ClearMemory041063/DigitalReadout/Pictures/DrillingPatternofHoles.png

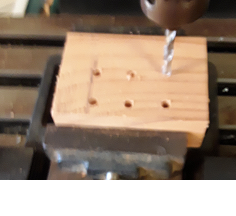
Pictures/DrillingPatternofHoles.png
