ClearMemory041063/DigitalReadout/Software/SDRO1H_03.pdf

SDRO1H_03 Adding a File Picker Joe McCarty
Introduction
The previous versions of SDRO1 used file path and filename editor boxes to read a commas separated pattern file. The SDRO1H_03 changes this to provide an implicitly activated file picking application. The application used is AndExplorer by Lyseoft. https://play.google.com/store/apps/details?id=lysesoft.andexplorer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

Operation:

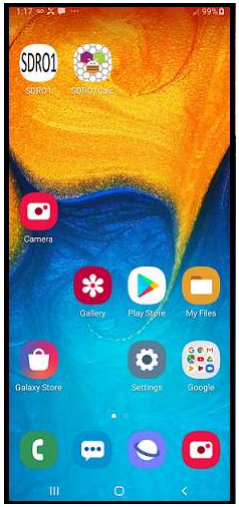
[picture p10: figure]

Start the SDRO1 Application

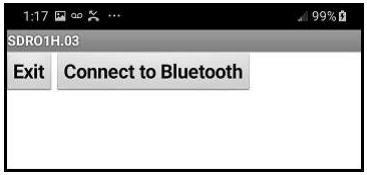
[picture p11: figure]

SDRO1 opens, press the Connect to Bluetooth button

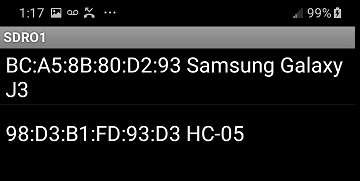
[picture p12: figure]

Select the Arduino circuit device from the list of paired Bluetooth devices.

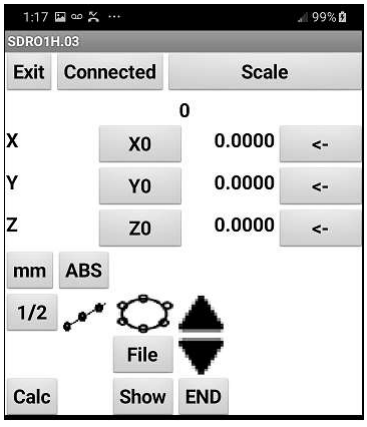
[picture p13: figure]

The Main SDRO1 screen appears. Press the file button.

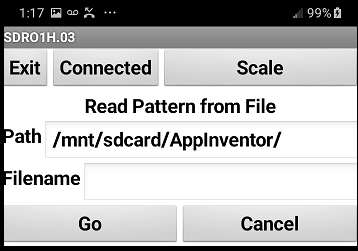
[picture p14: figure]

The Read Pattern from File screen appears. Edit the starting search path if needed. Press GO

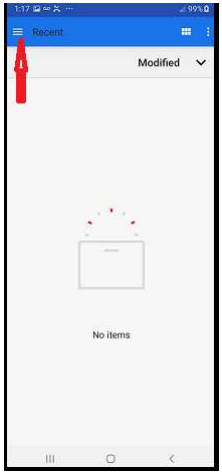
[picture p15: figure]

The content of this screen will depend on your Android device and the loaded Apps. Press the 3 bar button at the upper left marked in this screenshot by the red arrow.

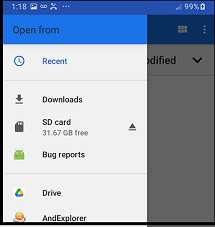
[picture p16: figure]

Again the screen content will vary. Select the AndExplorer

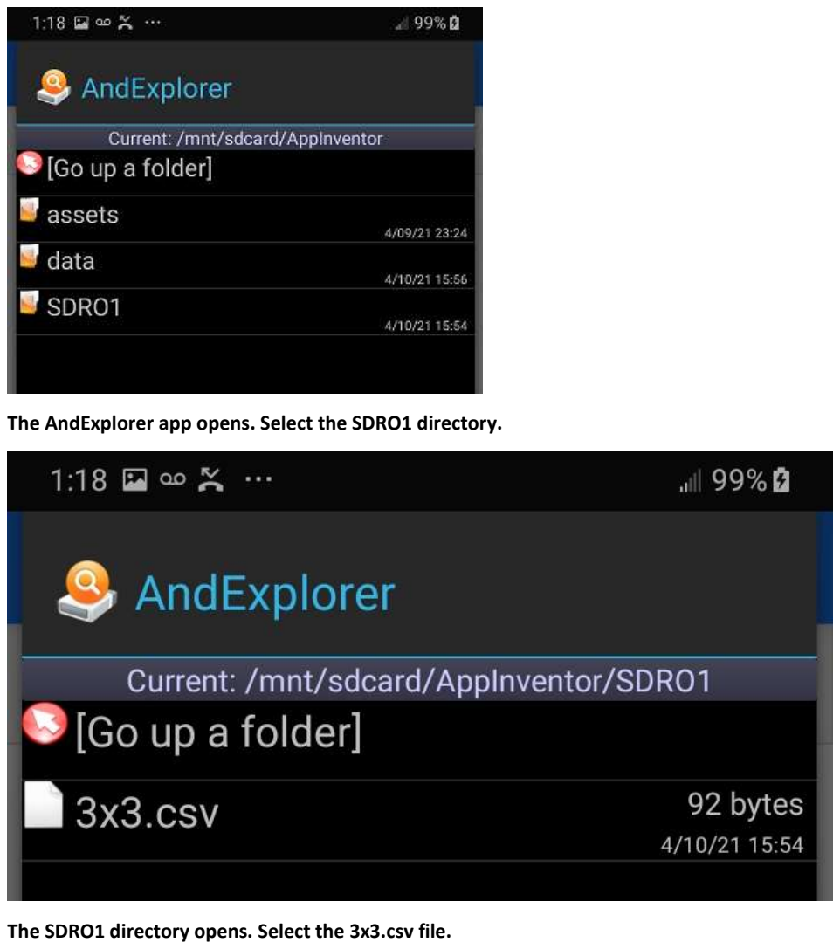
[picture p17: page 5]

The AndExplorer app opens. Select the SDRO1 directory.

The SDRO1 directory opens. Select the 3x3.csv file.

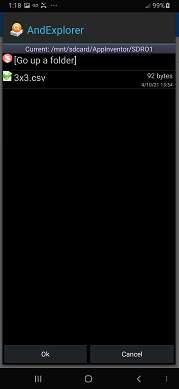
[picture p18: figure]

The 3x3.csv file is selected. Press the OK button near the bottom left.

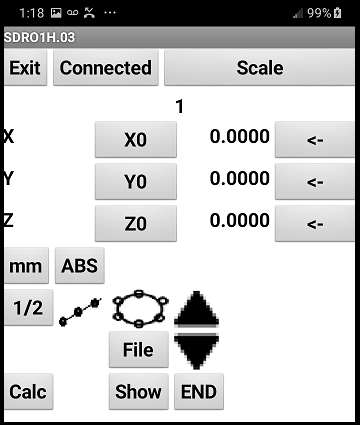
[picture p19: figure]

The file has been read. Press Show to see the results.

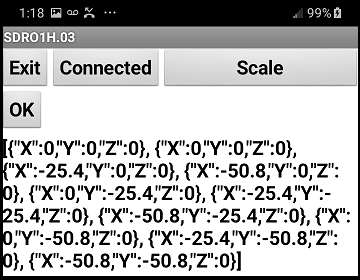
[picture p20: figure]

The data pattern imported from the 3x3.cav file.
