ClearMemory041063/DigitalReadout/AppInventorAIAfiles/Compilation Notes When Using Activity Starter to Launch an App from an App.pdf

Compilation Notes When Using Activity Starter to Launch an App from an App Joe McCarty

In this case SDRO1H_02 uses the App Inventor Activity Starter component to start SDRO1calc_B application. If you decide to recompile the calculator application a variable in the SDRO1H application will need to be changed as well.
The Block in SDRO1H

Wil need to change.

### 1. Once the calculator application is ready

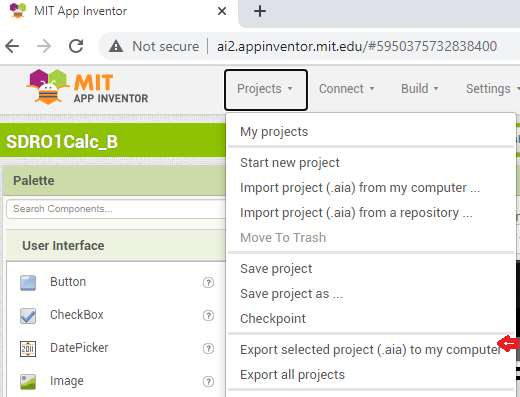
[picture p28: figure]

Export it as an aia file.

### 2. Copy the aia file to a suitable location and change the aia extension to zip

### 3. Unzip the file

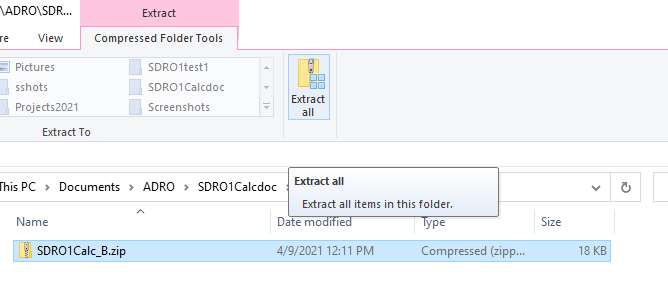
[picture p29: figure]
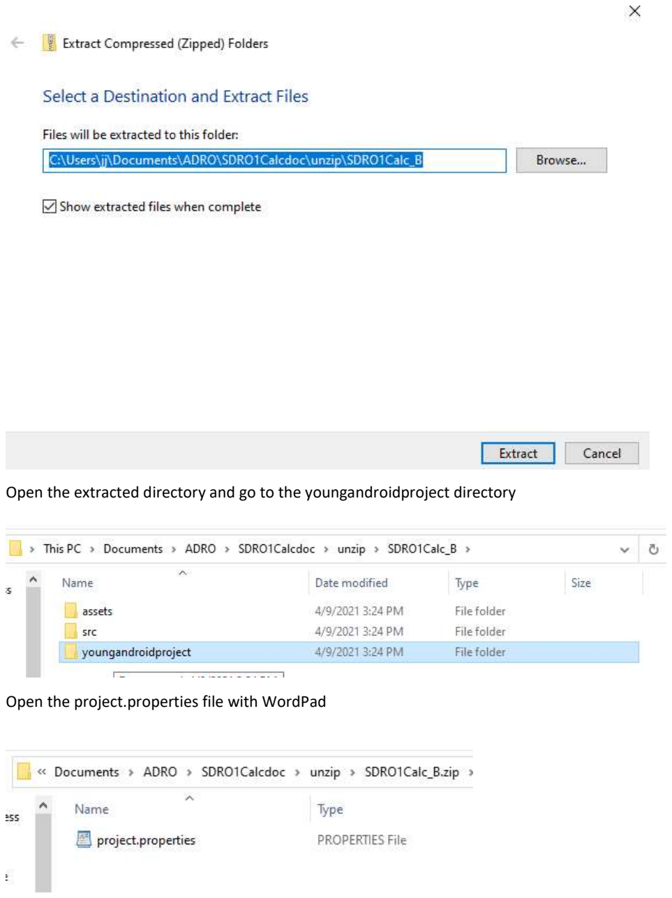
[picture p30: page 3]

Open the extracted directory and go to the youngandroidproject directory

Open the project.properties file with WordPad

The first line starting with main supplies the needed information.

main=appinventor.ai_joemac5774.SDRO1Calc_B.Screen1
