ClearMemory041063/DigitalReadout/TestRun/SDRO1 Drilling a Pattern of Holes Test.pdf

SDRO1 Drilling a Pattern of Holes Test Joe McCarty

Setup

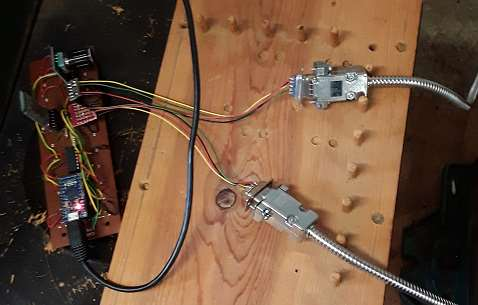
[picture p42: figure]

The rotary encoders for the X and Y axis were unplugged and DB9 connectors were installed and connected to the X and Y axis linear sensors on the milling machine.

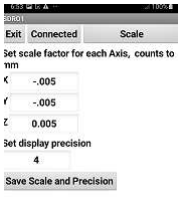
[picture p43: figure]

The SDRO1 application was started and the Scale option was used to set -0.005 into the X and Y axis so that readings from the sensors conform to the milling machine. The first bug was discovered here. The inch/mm is not being read correctly from the Android tinyDB. Pressing the inch/mm button a couple of times resolves the issue for now. I’ve made a note to fix this.

Centering

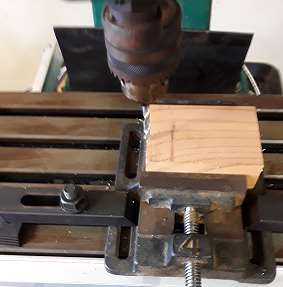
[picture p44: figure]

A section of 2x4 lumber was clamped into the vise and the X-axis moved to the left edge of the workpiece. The X-axis was zeroed in Incremental mode.

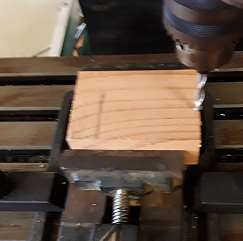
[picture p45: figure]

The X-axis was then moved to the right edge of the workpiece.

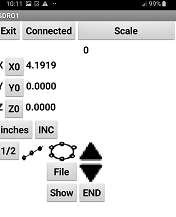
[picture p46: figure]

The X-axis shows the position of the drill bit over the right edge of the work piece.

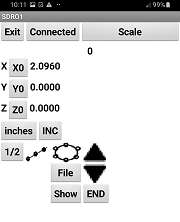
[picture p47: figure]

Pressing the ½ button changes the X-axis display to one half of its previous value.

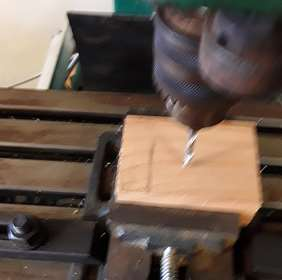
[picture p48: figure]

The handle of the X-axis is turned to bring the X-Axis display to zero. This centers the drill bit on the X-axis of the workpiece.

The process is repeated to center the Y-Axis.

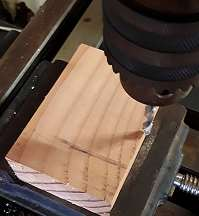
[picture p49: figure]
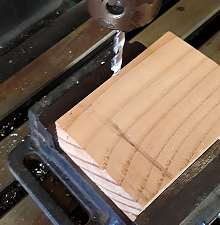
[picture p50: figure]
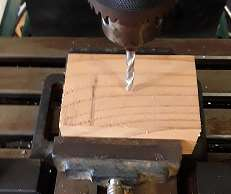
[picture p51: figure]

Drill bit centered over the workpiece

Move to Starting point X=-1, Y=-1

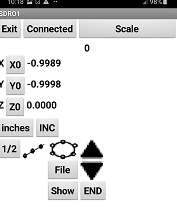
[picture p52: figure]
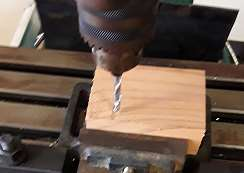
[picture p53: figure]

Zero the X and Y axis on the Android display
Drilling the 3x3 Hole Pattern from a CSV File
Pressing the File button on the App brings up this screen.

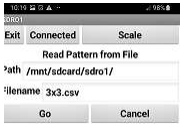
[picture p54: figure]

Press Go to load the file.

Press Show to display the JSON pattern in mm

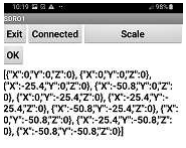
[picture p55: figure]

Press OK
Drill the first hole

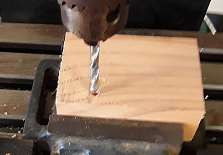
[picture p56: figure]

To go to the next hole press the | key. To go to the previous hole press the | key.
The End button will end the pattern and clear it from the App.

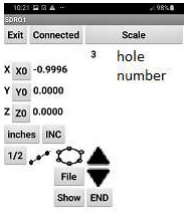
[picture p57: figure]

At hole number 2 position the up arrow was pressed for hole 3. The machine’s X-Axis handle is then turned to zero the X-Axis.

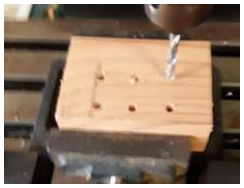
[picture p58: figure]

Drilling the 6th hole

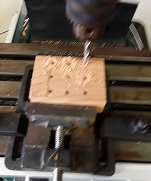
[picture p59: figure]

Finished the 9th hole.

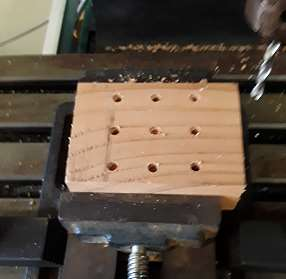
[picture p60: figure]

The 3x3.csv file content.

SDRO1
Units | 25.4
X | Y | Z
0 | 0 | 0
1 | 0 | 0
2 | 0 | 0
0 | 1 | 0
1 | 1 | 0
2 | 1 | 0
0 | 2 | 0
1 | 2 | 0
2 | 2 | 0
