ClearMemory041063/DigitalReadout/(commit log)

2021-04-04 Create downer.png
    Down button image
2021-04-04 Create FlangeBolt.png
    Circle of holes image
2021-04-04 Create lineholes.png
    Line of holes image
2021-04-04 Create QuadDemodBT3.ino
    Arduino Code
2021-04-04 Create ADRO_bb.png
    A Fritzing diagram of the circuit
2021-04-04 Create 3x3.csv
    CSV pattern file of 3 by 3 holes on 1 inch centers
    [3x3.csv]
2021-04-04 Create resistorValueNote.txt
    Note resistor values
2021-04-08 Create SDRO1 Drilling a Pattern of Holes Test.pdf
    Connect circuit to milling machine, set scale, load the 3x3.csv pattern and drill the pattern into a piece of wood.
2021-04-08 Fixed mm/inch button
    Fixed mm/inch button
